fieldkit/sonar/hardware/fk-sonar.kicad_pcb

## KiCad design hardware/fk-sonar.kicad_pcb (2019-01-02)

Schematic: fk-sonar.sch, fk-core

Parts:
C1, C12: 4.7uF; CAP-0603
C2, C5, C7, C8, C9, C15, C16, C17, C19, C20: 100nF; CAP-0603
C3, C4: 18pF; CAP-0603
C6, C10, C11: 1uF; CAP-0603
C13: 4.7nF; CAP-0603
C14, C18: 10uF; CAP-0603
D1: Orange; LED-0603
D2: PRTR5V0U2X; SOT-143B
D3: Green; LED-0603
F1: MF-PSMF050X-2; MF-PSMF020X
J1: CONN_01x03; Molex_CLIK-Mate_502382-0370_1x03_P1.25mm_Vertical
J2: CONN_02x05_SWD; HDR_02x05_Pitch1.27mm_SMD_SWD
J3: MICRO-USB; USB_10118193-0001LF-core-mod
J4: MICRO-USB; USB_1051330011
J5, J7: CONN_01x02; SJ_OPEN
J6, J12, J13: CONN_01x04; Molex_CLIK-Mate_502382-0470_1x04_P1.25mm_Vertical
J8: CONN_01x03_SERIAL; Molex_CLIK-Mate_502382-0370_1x03_P1.25mm_Vertical
J9, J10: CONN_01x05; Molex_CLIK-Mate_502382-0570_1x05_P1.25mm_Vertical
J11: CONN_01x04; BM04B-SRSS-TB
L1, L2: BLM18KG221SN1D; IND-0603
M1, M3, M4, M6: MOUNT_HOLE; HOLE_NPTH_2.7MM
M2, M5: FIDUCIAL; FIDUCIAL-1MM
Q1: 2N7002LT1G; SOT-23
R1: 2K2; RES-0603
R2, R7, R9: 10K; RES-0603
R3, R5: 330R; RES-0603
R4: 1M; RES-0603
R6, R11, R12: 100K; RES-0603
R8, R10: ?; RES-0603
R13, R14, R15, R16: 4.7K; RES-0603
R17: 2k2; RES-0603
SW1: SPNO; SW_SPST_WURTH_1
U1: ATSAMD21G18A-AU; TQFP-48_7x7mm_Pitch0.5mm
U2: MCP1700T-3302E/MB; SOT-89
U3: TPS2052B; SOIC-8-N
U4: S25FL116K0XMFI041; SOIC-8-N-WIDE
U7: SK6812
Y1: FC-135; ABS07

Connections:
3V3: C5.1, C8.1, C9.1, C11.1, C15.1, D1.2, D3.2, J1.3, J2.1, J5.1, J7.1, J9.1, J10.1, L1.2, R2.1, R6.1, R7.2, R9.2, R13.2, R14.2, U1.17 (VDDIO), U1.36 (VDDIO), U1.44 (VDDIN), U2.3, U3.2, U7.3
5V0: C10.1, C12.1, L2.1, U2.2
/A0: U1.3 (PA02)
/A1: J1.2, U1.7 (PB08)
/A2: U1.8 (PB09)
/A3: U1.9 (PA04), U7.2
/A4: U1.10 (PA05)
/A5: U1.47 (PB02)
/D0: U1.16 (PA11)
/D1: U1.15 (PA10)
/D2_RADIO_CS: U1.23 (PA14)
/D5: U1.24 (PA15)
/D6_FLASH_CS: U1.29 (PA20), U4.1 (~CS~)
/D7_SENSOR_EN: R10.1, U1.30 (PA21), U3.4
/D8_PERIPH_EN: R8.1, U1.11 (PA06), U3.3
/D9: U1.12 (PA07)
/D10: U1.27 (PA18)
/D11: U1.25 (PA16)
/D12: U1.28 (PA19)
/D13: Q1.1, U1.26 (PA17)
/D30: J8.3 (D30), U1.37 (PB22)
/D31: J8.2 (D31), U1.38 (PB23)
/D38_RADIO_D0: U1.22 (PA13)
/MISO: U1.21 (PA12), U4.2 (SO/IO1)
/MOSI: U1.19 (PB10), U4.5 (SI/IO0)
/PERIPH_3V3: C14.1, C16.1, C20.1, J5.2, R11.1, U3.7, U4.3 (~WP~/IO2), U4.7 (~HOLD~/IO3), U4.8 (VCC)
/RESET: R3.1, U1.40 (RESETN)
/RST: C19.1, J2.10, R2.2, R3.2, SW1.2
/RX_LED: U1.48 (PB03)
/SCK: U1.20 (PB11), U4.6 (SCLK)
/SCL1: J6.3, J11.4, J12.3, J13.3, R16.1, U1.32 (PA23)
/SCL3: J9.4, J10.4, R14.1, U1.14 (PA09)
/SDA1: J6.4, J11.3, J12.4, J13.4, R15.1, U1.31 (PA22)
/SDA3: J9.5, J10.5, R13.1, U1.13 (PA08)
/SENSOR_3V3: C17.1, C18.1, J6.1, J7.2, J11.2, J12.1, J13.1, R12.1, R15.2, R16.2, U3.6
/SWCLK: J2.4, U1.45 (PA30)
/SWDIO: J2.2, U1.46 (PA31)
/TX_LED: U1.39 (PA27)
/USB+: D2.2, J3.3, J4.3, U1.34 (PA25)
/USB-: D2.3, J3.2, J4.2, U1.33 (PA24)
/USB_ID: R5.2, U1.41 (PA28)
GND: C1.2, C2.2, C3.1, C4.1, C5.2, C6.2, C7.2, C8.2, C9.2, C10.2, C11.2, C12.2, C13.2, C14.2, C15.2, C16.2, C17.2, C18.2, C19.2, C20.2, D2.1, J1.1, J2.3, J2.5, J2.9, J3.5, J4.5, J6.2, J8.1 (GND), J9.2, J10.2, J11.1, J12.2, J13.2, Q1.2, R4.2, R8.2, R10.2, R11.2, R12.2, R17.2, SW1.1, U1.5 (GNDANA), U1.18 (GND), U1.35 (GND), U1.42 (GND), U2.1, U3.1, U4.4 (VSS), U7.1
unnamed: C1.1, C2.1, U1.4 (PA03)
unnamed: C3.2, U1.2 (PA01), Y1.1
unnamed: C4.2, U1.1 (PA00), Y1.2
unnamed: C6.1, U1.43 (VDDCORE)
unnamed: C7.1, L1.1, U1.6 (VDDANA)
unnamed: C13.1, J3.7, J4.6, R4.1
unnamed: D1.1, R1.1
unnamed: D3.1, R17.1
unnamed: F1.1, L2.2
unnamed: J3.4, J4.4, R5.1, R6.2
unnamed: Q1.3, R1.2
unnamed: R7.1, U3.8
unnamed: R9.1, U3.5
VUSB: D2.4, F1.2, J3.1, J4.1

Notes on the sheet:
MOUNTING
FIDUCIALS
SERIAL FLASH
MCU
TX0
RX0
16Mbit = 2Mbytes
M2.5 size
1.27 mm (0.05")
32.768kHz
12.5pF
LEDS
PERIPHERALS
EXTERNAL SENSORS
CORE CONNECTOR
USB / POWER MANAGEMENT
BUTTONS
SERIAL & ANALOG CONNECTORS

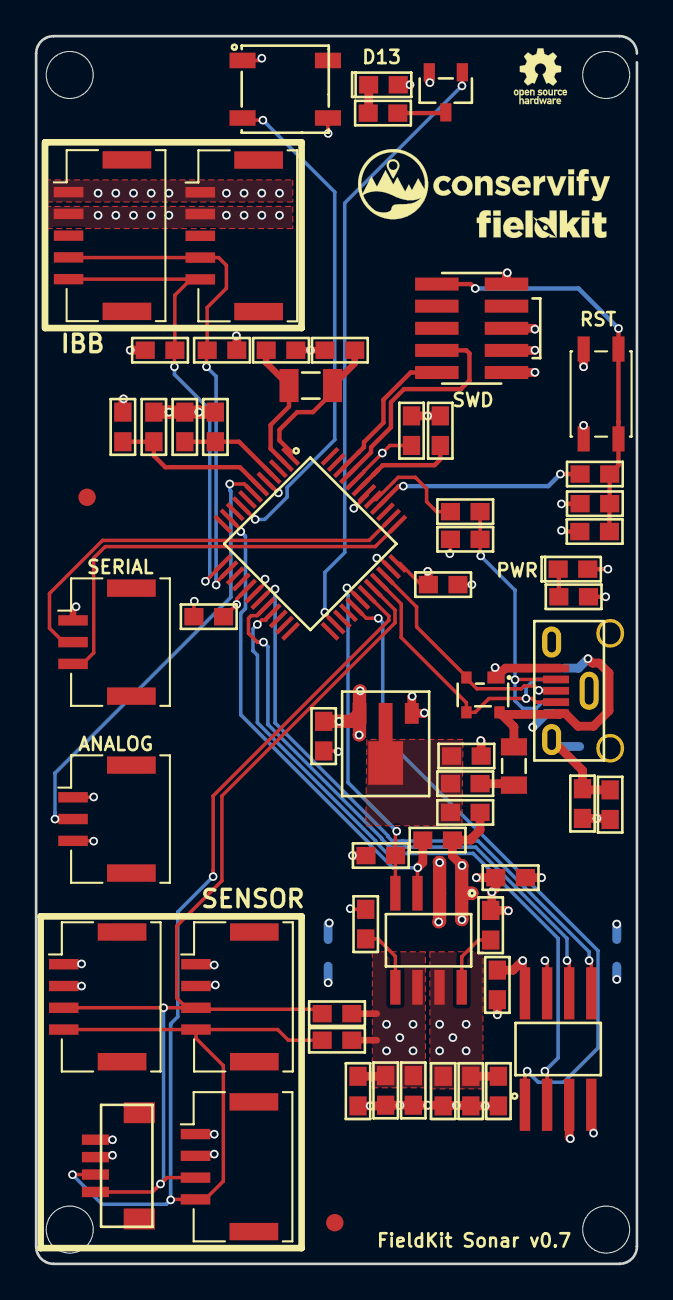
[picture p1: board fk-sonar.kicad_pcb from above]

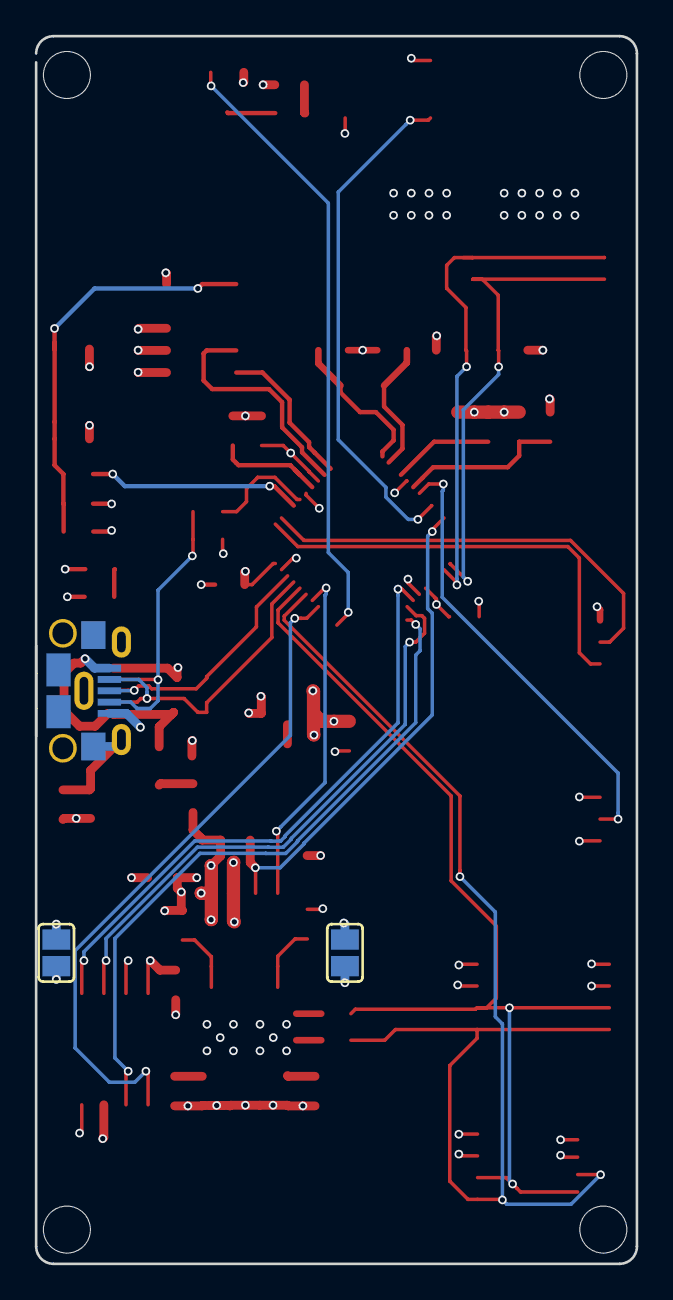
[picture p2: board fk-sonar.kicad_pcb from below]

Board: 4 copper layers, 34.5 x 70.5 mm, 70 parts (3 on the bottom side), 41 nets.
