fieldkit/sonar/firmware/module/main.cpp

#include <fk-module.h>

#include "board_definition.h"
#include "sonar_module.h"

extern "C" {

void setup() {
    Serial.begin(115200);

    fk::board.disable_everything();

    while (!Serial && millis() < 2000) {
        delay(100);
    }

    if (!Serial) {
        // The call to end here seems to free up some memory.
        Serial.end();
        Serial5.begin(115200);
        log_uart_set(Serial5);
    }

    firmware_version_set(FIRMWARE_GIT_HASH);
    firmware_build_set(FIRMWARE_BUILD);
    firmware_compiled_set(DateTime(__DATE__, __TIME__).unixtime());

    loginfof("Module", "Starting (%lu free)", fk_free_memory());

    fk::SensorInfo sensors[5] = {
        { "raw", "" },
        { "voltage", "mv" },
        { "distance", "m" },
        { "depth", "m" },
        { "mounted", "m" },
    };

    fk::SensorReading readings[5];

    fk::ModuleInfo info = {
        fk_module_ModuleType_SENSOR,
        8,
        5,
        3,
        "Sonar",
        "fk-sonar",
        sensors,
        readings,
        0,
        fk_module_RequiredUptime_READINGS_ONLY,
    };

    fk::SonarModule module(info);

    module.begin();

    while(true) {
        module.tick();
        delay(10);
    }
}

void loop() {
}

}
