fieldkit/sonar/firmware/module/sonar_hardware.h

#ifndef FK_SONAR_HARDWARE_H_INCLUDED
#define FK_SONAR_HARDWARE_H_INCLUDED

#include <cinttypes>

namespace fk {

constexpr uint8_t FK_SONAR_PIN_PERIPH_ENABLE = 8;
constexpr uint8_t FK_SONAR_PIN_RADIO_CS = 5;
constexpr uint8_t FK_SONAR_PIN_RADIO_DIO0 = 2;
constexpr uint8_t FK_SONAR_PIN_FLASH_CS = 6;

}

#endif
