fieldkit/sonar/(commit log)

2017-11-17 A basic ATSAMD now with an analog sensor connector.
    [fk-sonar.kicad_pcb, fk-sonar.sch]
2017-11-17 Copying fk-core, actually and dropping GPS/SD/etc.
    [fk-sonar.sch]
2017-11-17 High level layout on the PCB.
    [fk-sonar.kicad_pcb]
2017-11-29 The PCB.
    [fk-sonar.kicad_pcb, fk-sonar.sch]
2017-12-08 Adding gerbers.
    [fk-sonar-B.Cu.gbr, fk-sonar-B.Mask.gbr, fk-sonar-B.Paste.gbr, fk-sonar-B.SilkS.gbr, fk-sonar-Edge.Cuts.gbr, fk-sonar-F.Cu.gbr, fk-sonar-F.Mask.gbr, fk-sonar-F.Paste.gbr]
2017-12-18 Align the labels on fab layer for easier assembly.
    [fk-sonar.kicad_pcb]
2017-12-19 New SWD/JTAG programming footprint to avoid confusion.
    [fk-sonar.kicad_pcb, fk-sonar.sch]
2017-12-19 Using our MICRO-USB with the larger, non oval drills.
    [fk-sonar.kicad_pcb]
2017-12-19 Adding a solar panel connector. Just a JST below the battery JST.
    [fk-sonar.kicad_pcb, fk-sonar.sch]
2017-12-20 Fix led pin. This one uses A2, A4, A5, and D13.
    [main.cpp]
2017-12-20 Labels on SDA/SCL header. Also made GND the square pad.
    No room for the label there.
    [fk-sonar.kicad_pcb, fk-sonar.sch]
2017-12-22 Easier fab label placements.
    [fk-sonar.kicad_pcb]
2017-12-28 Just some cleanup. Fix the fuel gauge lines.
    [fk-sonar.kicad_pcb, fk-sonar.sch]
2017-12-29 Exposing D30/D31 (as test points because stuff is kind of cramped)
    If this becomes more regular/useful I'll make them pins or use a header.
    [fk-sonar.kicad_pcb, fk-sonar.sch]
2018-05-01 Switch to our RadioHead fork.
2018-05-04 Fix USB footprint. Add a Molex for D30/D31 serial.
    [fk-sonar.kicad_pcb, fk-sonar.sch]
2018-05-21 Updating BOM details.
    [fk-sonar.sch]
2018-06-29 Change orientation of sonar sensor connector. Matches the harness we have.
    [fk-sonar.kicad_pcb, fk-sonar.sch]
2018-07-03 Adding main connector and mounting holes. Bump version to v0.3
    [fk-sonar.kicad_pcb, fk-sonar.sch]
2018-07-10 Plotting gerbers.
    [fk-sonar-B.Cu.gbr, fk-sonar-B.Mask.gbr, fk-sonar-B.Paste.gbr, fk-sonar-B.SilkS.gbr, fk-sonar-Edge.Cuts.gbr, fk-sonar-F.Cu.gbr, fk-sonar-F.Mask.gbr, fk-sonar-F.Paste.gbr]
2018-07-24 Upgrade to Kicad 5. Also adding SK6812 and molex connectors.
    [fk-sonar-2018-07-23-19-35-59.sch, fk-sonar.kicad_pcb, fk-sonar.sch]
2018-07-24 Silkscreen cleanup.
    [fk-sonar.kicad_pcb]
2018-07-24 Schematic layout.
    [fk-sonar.sch]
2018-07-27 New USB for vertical entry.
    [fk-sonar-B.Cu.gbr, fk-sonar-B.Mask.gbr, fk-sonar-B.Paste.gbr, fk-sonar-B.SilkS.gbr, fk-sonar-Edge.Cuts.gbr, fk-sonar-F.Cu.gbr, fk-sonar-F.Mask.gbr, fk-sonar-F.Paste.gbr]
2018-08-21 Use new Arduino CMake stuff.
2018-08-22 Consistent part values across our schematics.
    [fk-sonar.sch]
2018-08-22 Part updates.
    [fk-sonar.sch]
2018-08-24 Fix SK6812. Assign easier to read labels to signals.
    [fk-sonar.kicad_pcb, fk-sonar.sch]
2018-08-24 Align connectors on side. Add periph switch.
    [fk-sonar.kicad_pcb, fk-sonar.sch]
2018-08-24 Fixing rescued stuff and DRC checks.
    [fk-sonar.kicad_pcb, fk-sonar.sch]
2018-08-28 Use more compatible FP for flash.
    [fk-sonar.kicad_pcb, fk-sonar.sch]
2018-08-28 Consistency in part values
    [fk-sonar.sch]
2018-09-07 Bump version and plot gerbers.
    [fk-sonar-B.Cu.gbr, fk-sonar-B.Mask.gbr, fk-sonar-B.Paste.gbr, fk-sonar-B.SilkS.gbr, fk-sonar-Edge.Cuts.gbr, fk-sonar-F.Cu.gbr, fk-sonar-F.Mask.gbr, fk-sonar-F.Paste.gbr]
2018-09-26 Pin to newer library versions.
2018-10-04 Fix test's flash pin number. Log raw values from sensor during test.
    [main.cpp]
2018-10-04 Toggle peripherals. Also fix startup hang in module.
    [main.cpp, sonar_hardware.h, sonar_module.cpp, sonar_module.h]
2018-10-24 Pass peripherals enable pin to Module to control flash.
2018-10-24 Fix size of sensor readings array. Was off.
    This was causing us to blow away memory, and so we'd fail when taking the
    second reading. FK-507
    This should really be hard to fall victim to.
    [main.cpp]
2018-10-25 Log to Debug if opening USB Serial fails.
    [main.cpp]
2018-11-07 Adding some pull downs.
    [fk-sonar-B.Cu.gbr, fk-sonar-B.Mask.gbr, fk-sonar-B.Paste.gbr, fk-sonar-B.SilkS.gbr, fk-sonar-Edge.Cuts.gbr, fk-sonar-F.Cu.gbr, fk-sonar-F.Mask.gbr, fk-sonar-F.Paste.gbr]
2018-11-19 Moving labels around.
    [fk-sonar.kicad_pcb]
2018-12-04 Add orientation indicator to SWD fp.
    [fk-sonar.kicad_pcb, fk-sonar.sch]
2018-12-04 Switch to 2.7mm mounting holes.
    [fk-sonar.kicad_pcb, fk-sonar.sch]
2018-12-11 Removing I2C3 support that none of our boards use.
2018-12-12 Adding a board definition.
2018-12-20 Started removing unused portion of the design (battery and Lora)
    [fk-sonar.sch]
2018-12-26 Deleted charging, LoRa, fuel gauge, swapped out connectors and peripheral switch
    [fk-sonar.kicad_pcb, fk-sonar.sch]
2018-12-26 Finished rough placement of components, starting trace routing
    [fk-sonar.kicad_pcb, fk-sonar.sch]
2018-12-26 Finished routing traces, starting DRC
    [fk-sonar.kicad_pcb, fk-sonar.sch]
2018-12-26 Finished DRC
    [fk-sonar.kicad_pcb]
2018-12-26 Cleaned up schematic with labeling and dividers
    [fk-sonar.sch]
2018-12-26 Generated gerbes for v0.7
    [fk-sonar-B.Cu.gbr, fk-sonar-B.Mask.gbr, fk-sonar-B.Paste.gbr, fk-sonar-B.SilkS.gbr, fk-sonar-Edge.Cuts.gbr, fk-sonar-F.Cu.gbr, fk-sonar-F.Mask.gbr, fk-sonar-F.Paste.gbr]
2019-01-02 Changed board outline slightly to be on a 0.5 mm grid (for panelization)
    [fk-sonar-v0.07-03x03.kicad_pcb]
2019-01-02 Regenerated gerber files before moving to panelization
    [fk-sonar-B.Cu.gbr, fk-sonar-B.Mask.gbr, fk-sonar-B.Paste.gbr, fk-sonar-B.SilkS.gbr, fk-sonar-Edge.Cuts.gbr, fk-sonar-F.Cu.gbr, fk-sonar-F.Mask.gbr, fk-sonar-F.Paste.gbr]
2019-01-02 Shifted board to fit onto the grid better (mounting holes have not moved in either move)
    [fk-sonar-B.Cu.gbr, fk-sonar-B.Mask.gbr, fk-sonar-B.Paste.gbr, fk-sonar-B.SilkS.gbr, fk-sonar-Edge.Cuts.gbr, fk-sonar-F.Cu.gbr, fk-sonar-F.Mask.gbr, fk-sonar-F.Paste.gbr]
2019-01-02 Created 03x03 panelized version of fk-sonar v0.07 with gerbers
    [fk-sonar-v0.07-03x03-B.Cu.gbr, fk-sonar-v0.07-03x03-B.Mask.gbr, fk-sonar-v0.07-03x03-B.Paste.gbr, fk-sonar-v0.07-03x03-B.SilkS.gbr, fk-sonar-v0.07-03x03-Edge.Cuts.gbr, fk-sonar-v0.07-03x03-F.Cu.gbr, fk-sonar-v0.07-03x03-F.Mask.gbr, fk-sonar-v0.07-03x03-F.Paste.gbr]
2019-01-23 Drop fuel gauge and radio test. No longer on the board.
    [main.cpp]
2019-02-12 Cleaning up the sonar reading math.
2019-03-13 Fixed missing resistor values.
    [fk-sonar.sch]
2019-04-18 Fix bad array size, causing crashes.
    [main.cpp]
